Bytestring0/FPGA_RV32IM_VibeOS/README.md

> **2026-11-03 低资源架构重构：** [共享算术、TCM/DDR桥压缩、矩阵尺度融合及最终整机验收](docs/npu/AREA_REARCH_20261103.md)。保留硬件加速，已完成稳定CPU+NPU+Cache仿真；整机资源和时序正在真实PDS实现，板端模型吞吐与质量仍待验证。此前进度见[优化检查点](docs/npu/OPTIMIZATION_20261103.md)。

> **2026-11-02 NPU 集成交接：** 当前矩阵/tensor 加速器、Cache/DDR 集成修改、完整 Agent 构建和后续优化入口见 [NPU_HANDOFF.md](NPU_HANDOFF.md)。最新整机时序、板端吞吐和模型质量仍待验收。

# AG：六级流水线双发射 RISC-V CPU

面向紫光同创赛题一的自主 SystemVerilog CPU 与最小 SoC。支持 RV32IM + Zicsr/Zifencei + Zba/Zbb、六级顺序流水线、动态通道交换双发射、四项指令队列、局部历史预测和返回地址栈、精确异常与机器态中断。

2026-10-29 当前 AG 独立重建板测：**102 MHz、514.346581 CoreMark、5.042614 CoreMark/MHz、7023 LUT、0.073237446 CoreMark/LUT**，6000 轮用时 11.665286 秒，CRC、UART、JTAG 回读均通过；setup +0.156 ns。独立 ILA 版本同样闭合并通过完整基准，真实捕获 2048 点链表/CRC 循环，窗口退休 2286 条、IPC 1.1162，477 周期双退休。以上为 TCM SoC 指标，完整 DDR/Cache 配置独立统计。见[本次 AG 指标与 ILA 原始证据](docs/results/ag-contest-20261029/README.md)、[逐项赛题核验](docs/赛题一RV侧完成情况与指标.md)。108 MHz 已结束的对照未闭合，按用户要求不再实现。

项目现更名为 **AG**，生产 RTL、仿真、构建脚本和 DDR IP 使用 `ag_*`；历史归档保留原文件名、UART 和哈希。改名后两个完整 DDR/Cache 102 MHz 重建在限时内未完成布线，尚无新的完整 SoC 板测/CoreMark；[详细结果与日志](docs/results/ag-contest-20261029/README.md)已保留。

2026-10-29：**完整 CPU + 两路 I/D Cache（各 16 KiB）+ 板载 DDR3 的 102 MHz 冻结闭合版已通过实板自检与 JTAG 回读校验**。两次下载均通过 DDR 校准、数据/代码执行、MULH、MIN/MAX、Cache 命中、自修改及维护测试；第二次完成配置回读。该冻结位流 CPU setup +0.056 ns、slow/fast hold +0.136/+0.099 ns，整机 14618 LUT。短仿真 CoreMark 等效 5.041916/MHz，尚无完整 DDR/Cache 位流正式实板 CoreMark。见[本次实测证据](docs/results/board-ddr-cache-102mhz/README.md)、[原始闭合归档](docs/results/offline-ddr-cache-102mhz/README.md)、[RV 接口](docs/RV侧接口文档.md)。

历史 2026-10-26 TCM 位流为 7089 LUT、setup +0.120 ns、0.072556 CoreMark/LUT；2026-10-28 DDR 实验镜像 setup −1.022 ns，未闭合。历史数据分别见[性能与验证报告](docs/性能与验证报告.md)与[DDR 实验板测记录](docs/results/board-ddr-102mhz-experimental/README.md)，不可混用到当前 AG 的面积或成绩。

## 文档

- [板载 DDR3 接入与验证](docs/板载DDR3接入与验证.md)：IP 配置修正、时钟/引脚、CPU 接口、自检和独立 PDS 工程。
- [模型加速器整合与浏览器方案](docs/模型加速器整合与浏览器方案.md)：团队 W4A8 核心审查、模型候选，以及当前唯一确定的 AI 浏览器应用。

- [CPU 设计说明](docs/CPU设计说明.md)：架构、双发射、旁路、总线、CSR、地址空间及 OS/AI 接入边界。
- [AG OS 与即时应用设计](docs/AGOS与即时应用设计.md)：简化 VibeOS 的方案，含 AI 计算器、AI 网页、生成式应用商店、应用脚本、DDR 与持久化；目前为设计稿。
- [性能与验证报告](docs/性能与验证报告.md)：赛题三个性能指标、周期、资源、时序、限制与复现命令。
- [PDS 使用说明](docs/PDS使用说明.md)：解决“没有文件”、同步源码与运行流程。
- [NPU完整模型首次运行](docs/npu/NPU_MODEL_RUN_20261103.md)：完整W4模型通过生产NPU RTL协同仿真、54MHz物理实现与模型启动入口。
- [低资源NPU架构与实测](docs/npu/AREA_REARCH_20261103.md)：低资源重构、整机资源/时序、模型RTL和板端状态。
- [上板调试记录](docs/上板调试记录.md)：历史27/81/108 MHz测试、JTAG下载和证据位置。

## 在 PDS 中运行

打开 **D:\FPGA\RiscV\RiscV.pds**，顶层为 ag_fpga_top，器件 PG2L100H-6 / FBG676，综合器选择 ADS。

1. 关闭之前的空工程，避免将旧的空文件列表保存覆盖新工程。
2. 重新打开 RiscV.pds，源文件列表应包含 ag_all.sv。
3. 运行 Compile → Synthesize → Device Map → Place & Route → Report Timing。

修改原始 rtl/*.sv 后，在 PowerShell 中同步：

```powershell
Set-Location D:\FPGA\RiscV
.\scripts\sync_pds_project.ps1
```

该命令按 rtl/files.f 合并 RTL 文件到 fpga/generated/ag_all.sv，复制 smoke 固件到根目录 firmware.hex，并写入完整的 PDS 工程设置。只添加合并文件可规避旧版 PDS 的 package 兼容问题；不要同时添加原始模块。

独立命令行综合与布局布线：

```powershell
.\scripts\build_fpga.ps1
.\scripts\build_fpga.ps1 -PlaceRoute
```

根工程顶层使用原始 27 MHz 时钟与对应 UART 分频。根工程约束为 110 MHz 时序探索目标，不包含板级引脚分配，也不会自动生成 PLL；实板请使用 `scripts/prepare_board.ps1` 生成的完整板级工程。102 MHz 基准镜像位于 `build/board102-payload-refine/`，DDR 集成工程由 `scripts/prepare_ddr_board.ps1` 单独生成。源码、固件和时序按各自 manifest 核对，不能混用。外部 Flash 固化及断电启动尚未执行。

## 编译与仿真

依赖 WSL Ubuntu、make、g++、python3、Verilator、gcc-riscv64-unknown-elf 和 binutils-riscv64-unknown-elf。工具链虽叫 riscv64，编译明确选择 RV32/ILP32。

```bash
cd /mnt/d/FPGA/RiscV
make deps                        # 固定版本 CoreMark / riscv-tests
make check                       # ISA、异常、中断、双发射、差分、UART 波形
make coremark                    # RV32IM 普通 -O3 基线
make coremark-opt                # Zba/Zbb 与优化编译配置，短测 10 轮
make coremark-opt ITERATIONS=6000 CPU_HZ=110000000
make coremark-opt ITERATIONS=6000 CPU_HZ=110000000 VALIDATION=1
make smoke                       # 恢复仿真启动镜像
```

coremark-opt 使用完整上游算法，附加 -funroll-all-loops、-finline-limit=1000、-frename-registers、-mtune=sifive-7-series。最后一个选项仅调整 GCC 调度模型，不引入第三方 CPU IP。日志保存实际编译参数和三个算法 CRC。

CPU_HZ 仅用于计时换算；上板时必须等于实际主频。6000 次迭代用于按 110 MHz 换算时超过 10 秒的逻辑时间验证，仍然属于仿真结果。短测会显示上游持续时间不足提示，测试脚本只允许该提示，不忽略其他错误。

| Make 参数 | 默认 | 含义 |
| --- | ---: | --- |
| DUAL_ISSUE | 1 | 顺序双发射，0 为单发射 |
| LOAD_BYPASS | 1 | 成功的 MEM Load 响应旁路 EX |
| EARLY_LSU | 1 | EX 发起访存，MEM 接收同步响应 |
| PREDICT | 1 | 分支预测 |
| BTB_BITS | 8 | 256 项 BTB；可比较 6/8/9 |
| ITERATIONS | 10 | CoreMark 迭代次数 |
| VALIDATION | 0 | 0 为 performance，1 为 validation 种子 |
| CPU_HZ | 27000000 | 固件计时换算参数 |

Make 参数控制仿真；PDS 使用 RTL 默认参数。各 SoC 测试共享 build/firmware.hex，请顺序运行，不要在多个终端同时启动 make coremark/smoke/isa 等目标。

## 工程结构与交付边界

| 目录 | 内容 |
| --- | --- |
| rtl/ | CPU、ALU、译码、预测器、CSR、除法、SoC、FPGA 顶层 |
| sim/ | SoC 模型、独立退休参考模型、UART 波形检查 |
| tests/ | 异常、中断、双发射和 MMIO 专项 |
| sw/ | 启动、链接脚本、示例、CoreMark 移植层 |
| scripts/ | 固件生成、差分、PDS 构建和同步 |
| fpga/ | 工程模板、合并源码、约束 |
| docs/results/ | 选定版本的验证日志、资源及时序证据 |
| build/ | 可重新生成的中间文件与实验日志 |
| third_party/ | 固定版本基准/测试代码及许可证 |

最小 SoC 集成 64 KiB TCM、UART TX、GPIO、定时器和软件中断。另有可选 DDR 集成：PDS HMIC_S IP、跨时钟桥，以及独立的两路 I/D Cache（板级各 16 KiB、32 字节行、D 写回/写分配、FENCE.I 维护）。Cache 已通过功能/性能仿真，并有 102 MHz 实验镜像通过 DDR、自修改代码、维护及 JTAG 板测；该镜像 14,603 LUT、setup −0.306 ns，尚未闭合。当前源码仍在优化，完整状态及冻结证据见 [Cache 设计与性能](docs/两路Cache设计与性能.md)。操作系统、AI 加速器系统整合、键盘/HDMI、UART RX 与持久化存储尚未实现。

## RV 侧交付文档

- [RV 侧接口文档](docs/RV侧接口文档.md)：端口协议、MMIO、DDR/Cache、异常中断和后续 AI 接入边界。
- [赛题一 RV 侧完成情况与指标](docs/赛题一RV侧完成情况与指标.md)：逐条对照、分版本指标、原始证据和待验收事项。
