Bytestring0/FPGA_RV32IM_VibeOS/提交材料/05_时序与资源/README.md

# 时序与资源（PDS 2025.2）

## 已闭合工程：`npu_hot102_20261104`
- 时序报告结论：**Design Summary : All Constraints Met**
- CPU 时钟：102 MHz（正裕量 +0.176 ns）
- DDR PHY 时钟：正裕量 +0.251 ns
- 综合资源：LUT **46,747 / 66,600（70.19%）**；DRM 99.5 / 155（64.19%）；APM 116 / 240（48.33%）
- 位流：`08_位流与镜像/ag_npu_board_top_sbit_hot102.bin`（已在实板运行）

原始报告：`timing_hot102.rtr`

## 进行中：真突发版（`npu_burst16_102_20261104`）
- 综合：LUT 46,782（70.24%），DRM 100.0，APM 115.0 —— 与闭合版基本一致
- 首次布线：**未闭合**，WNS −0.441 ns，失败路径为 TCM 写使能跨 RAM bank 走线（非突发逻辑）
- 正在用第二个布局种子重跑

## 说明
- 表中数字均取自 PDS 报告，未做估算。
- 突发版在时序闭合前**不进入提交与实板**。
