Bytestring0/FPGA_RV32IM_VibeOS/提交材料/07_AI应用/待补_HDMI截图.md

# HDMI 界面截图（待补）

需要归档：
1. 主菜单（5 个条目）
2. 虚拟键盘输入态
3. 工具调用与回执
4. CoreMark 结果页
5. 模型装载进度条

拍摄/截取后放入本目录，并在 `07_AI应用/README.md` 中引用。
