Bytestring0/FPGA_RV32IM_VibeOS/提交材料/07_AI应用/待补_识别率.md

# 识别率 / 任务成功率（未测）

**当前没有任何可提交的量化数据。**

需要补的测量方案（建议）：
1. 固定 20–50 条任务提示（计算类、查询类、计时类、自由问答类各若干）
2. 每条记录：是否调用正确工具、参数是否正确、最终答复是否正确
3. 统计：工具调用成功率、任务完成率、错误类型分布

注意：模型 `quality_approved=0`，在完成上述测量前不得声称达到 BF16 等价质量。
