Bytestring0/FPGA_RV32IM_VibeOS/提交材料/09_演示视频/待补_演示视频.md

# 演示视频（待录制）

建议录制内容：
1. 上板启动 → HDMI 主菜单
2. 按键选择 AI 任务 → 装载进度条 → 模型推理与工具调用回执
3. 虚拟键盘/串口键盘输入一句自由对话
4. CoreMark 页面现场跑分（≥10 秒）与结果
5. （若完成）ILA 抓取波形演示
