Bytestring0/FPGA_RV32IM_VibeOS/docs/results/cache-area/manual/hardware-p20.png

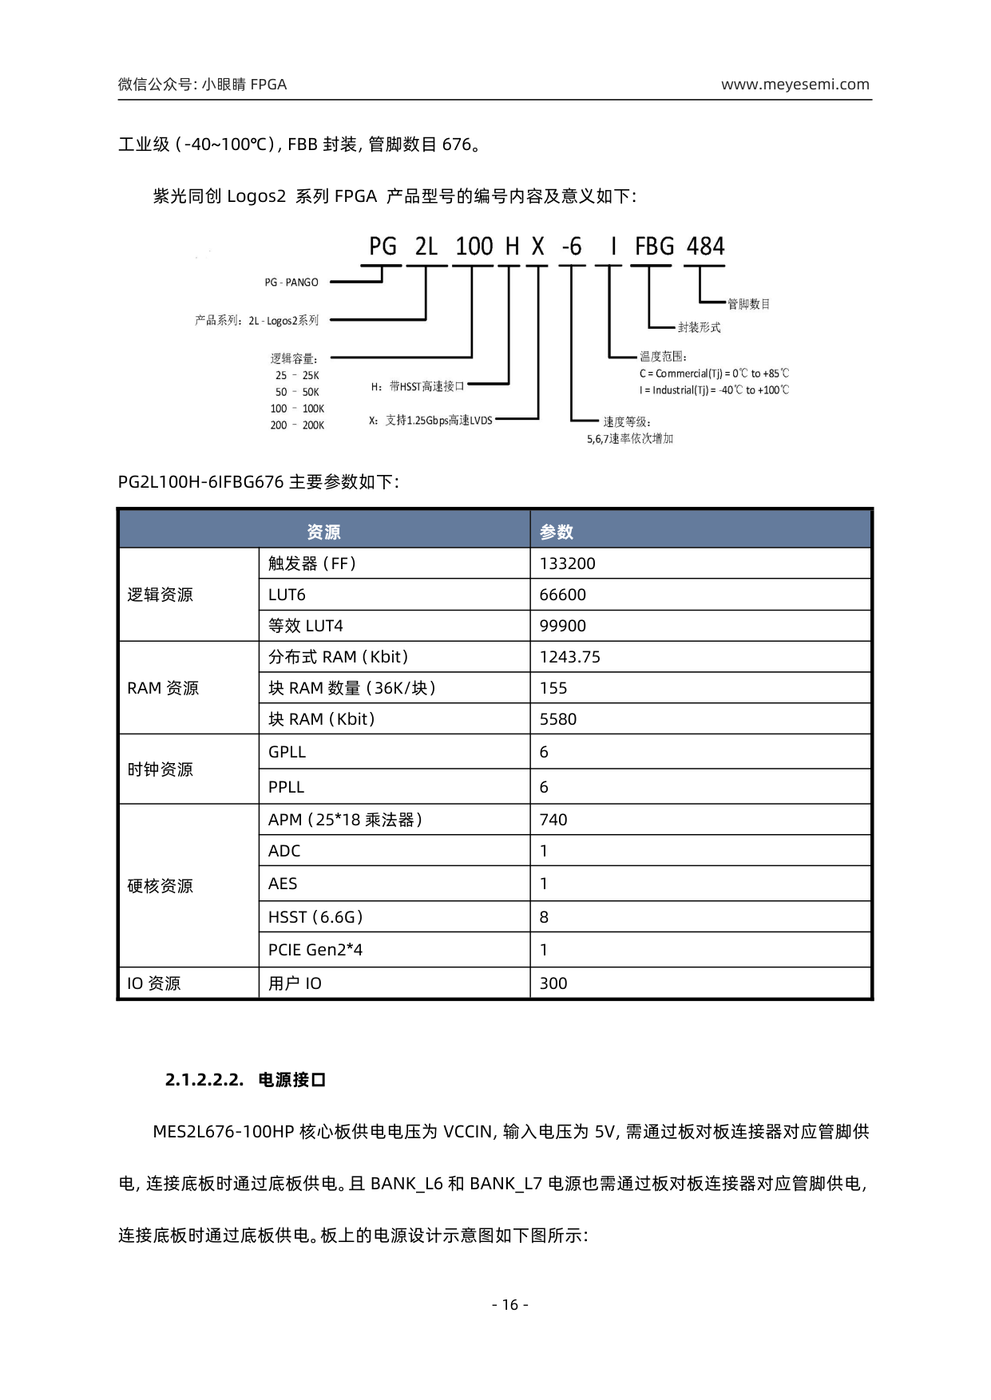
docs/results/cache-area/manual/hardware-p20.png
