Bytestring0/FPGA_RV32IM_VibeOS/docs/results/cache-timing-candidates/README.md

# 时序候选记录

2026-10-29，板卡未连接。Word-only Load 旁路候选（MULH_PIPELINE=1、LOAD_WORD_ONLY=1）通过 219 轮差分，102240 条提交指令；仅改变板级参数，不改变通用核默认值。该记录不构成时序或板测通过证明。物理实现结果另见赛题完成情况文档。
