Bytestring0/FPGA_RV32IM_VibeOS/docs/results/cache-timing-candidates/seed1-first/README.md

# 完整旁路、布局种子 1：第一轮最终路由

2026-10-29。当前源码，CPU 102 MHz、DDR UI 125 MHz、I/D 各 16 KiB。CPU setup −0.095 ns、9 个端点；DDR PHY 域到输出域有一条 −0.461 ns，故整机不通过时序。没有生成或下载正常位流。hold 优化参数为 100 ps；报告与资源来自第一轮完成的独立实现目录，后续迭代不继承为本轮通过结果。
