Bytestring0/FPGA_RV32IM_VibeOS/docs/results/cache-timing-candidates/seed1-priority-incomplete/README.md

# 种子 1 优先布线尝试：未完成，不可生成正常位流

源代码与 seed1-first 相同。布线过程到达 0 未连接网络，但进程结束后没有留下最终 PNR 数据库和 report_timing 报告；此处仅保留中间 hold 修复后的摘要。

中间 CPU setup −0.566 ns（13 个端点），DDR PHY 快角 hold −0.009 ns。不能称为收敛，也不能用该摘要替代正式最终报告。下一步已改 RTL，将旋转和位计数运算从 EX 旁路路径移到已有 MEM 级。
