Bytestring0/FPGA_RV32IM_VibeOS/docs/results/cache-timing-candidates/word1-first/README.md

# 字加载旁路候选，不采用

2026-10-29。第一轮最终 CPU setup −0.630 ns，89 个端点，DDR UI +1.146 ns，各时钟 hold 通过。不能闭合 102 MHz，也未证明相对完整旁路的收益，停止后续迭代，保留 LOAD_WORD_ONLY=0 默认性能配置。没有生成或下载正常位流。差分通过不代表静态时序通过。
