Bytestring0/FPGA_RV32IM_VibeOS/docs/results/ag-contest-20261029/ila-analysis/samples.csv

sample | time_ns | x_pc | m_pc | retire_valid | retire_second_valid | x_dec_branch | x_function
0 | 0.0 | 00000588 | 00000494 | 0 | 0 | 1 | core_bench_list
1 | 9.803921568627452 | 00000498 | 00000494 | 0 | 0 | 0 | core_bench_list
2 | 19.607843137254903 | 000004a0 | 00000498 | 0 | 0 | 0 | core_bench_list
3 | 29.41176470588235 | 000004a4 | 000004a0 | 1 | 1 | 1 | core_bench_list
4 | 39.21568627450981 | 000004a8 | 000004a4 | 1 | 0 | 0 | core_bench_list
5 | 49.01960784313726 | 000004b0 | 000004a8 | 1 | 0 | 1 | core_bench_list
6 | 58.8235294117647 | 00000494 | 000004b0 | 1 | 1 | 1 | core_bench_list
7 | 68.62745098039215 | 00000494 | 000004b0 | 1 | 0 | 1 | core_bench_list
8 | 78.43137254901961 | 00000494 | 000004b0 | 0 | 0 | 1 | core_bench_list
9 | 88.23529411764706 | 00000494 | 000004b0 | 0 | 0 | 1 | core_bench_list
10 | 98.03921568627452 | 000004b4 | 000004b0 | 0 | 0 | 1 | core_bench_list
11 | 107.84313725490196 | 000004b8 | 000004b4 | 0 | 0 | 1 | core_bench_list
12 | 117.6470588235294 | 000004b8 | 000004b4 | 1 | 0 | 1 | core_bench_list
13 | 127.45098039215686 | 000004b8 | 000004b4 | 0 | 0 | 1 | core_bench_list
14 | 137.2549019607843 | 000004b8 | 000004b4 | 0 | 0 | 1 | core_bench_list
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
