Bytestring0/FPGA_RV32IM_VibeOS/docs/上板调试记录.md

# AG CPU 上板调试记录

首次测试时间：2026-10-22；最新 AG CPU 基准与 ILA 板测：2026-10-29。使用 PDS 2022.2-SP6.1、FTDI JTAG 下载器和板载 CP210x 串口。

## 当前 AG 重建基准与 ILA：2026-10-29

当前源码独立生成的 TCM 工程在 102 MHz 闭合，setup +0.156 ns；7023 LUT / 2563 FF。6000 轮 CoreMark 1,189,859,177 周期，11.665286 秒，514.346581 CoreMark，5.042613543/MHz，0.073237446/LUT；CRC、COM12 输出与执行结束后的 JTAG 回读均通过。独立 ILA 工程 setup +0.313 ns / 7655 LUT，完整基准周期不变且回读通过。实板立即采样取得 2048 点链表/CRC 循环，窗口 IPC 1.116210938，477 周期双退休；原始 WDF、截图、CSV 与限制详见[当前 AG 证据](results/ag-contest-20261029/README.md)。108 MHz 已完成对照未闭合，用户要求不再继续该频点。下文保留历史记录。

## 最新闭合 DDR/Cache 板测：2026-10-29

完整 CPU 102 MHz、DDR UI 125 MHz、DDR3 1000 MT/s、I/D Cache 各 16 KiB 的冻结闭合版已在 COM12 上两次下载并通过功能自检。第二次在自检结束后完成 JTAG 配置回读，ID `0x00602899`。首次遗漏 `.smsk` 导致回读失败，补齐同版掩码并核对位流哈希后重测通过；原始日志全部保留。见[本次实测归档](results/board-ddr-cache-102mhz/README.md)。未写 Flash，未测该完整 SoC 的正式 CoreMark。以下旧名、旧路径和 UART 原文为历史记录；当前 AG 脚本生成 `ag_*` 工程，旧 profile 应使用冻结版本脚本。

## 历史 DDR 功能板测：2026-10-28

CPU 102 MHz、DDR3 1000 MT/s 实验配置已通过校准、16 KiB 数据、字节/半字写、地址线/末字抽查及 DDR 代码执行，完整 UART PASS 与 JTAG 校验通过。当前最后下载至配置 RAM 的镜像为 `build/ddr-soc102-grant-refine/generate_bitstream/qinglong_board_top.sbit`，未写 Flash。该 DDR 整机 CPU setup −1.022 ns，尚未闭合。证据见[DDR 实验板测归档](results/board-ddr-102mhz-experimental/README.md)。

## 最新 CPU 基准：102 MHz 时序闭合并上板

| 配置 | 实板 CoreMark | CoreMark/MHz | 实现后 LUT | CoreMark/LUT | 状态 |
| --- | ---: | ---: | ---: | ---: | --- |
| 81 MHz，6000 次迭代 | 408.451697 | 5.042614 | 6803 | 0.060040 | 两次一致；setup/hold 全部通过 |
| 102 MHz，6000 次迭代 | 514.346581 | 5.042614 | 7089 | 0.072556 | UART、JTAG 校验通过；setup/hold 全部通过 |
| 108 MHz，8000 次迭代 | 544.602348 | 5.042614 | 7124 | 0.076446 | 两次一致；setup WNS −0.346 ns，尚未闭合 |

102 MHz 为当前同时满足最终时序和实板基准的最高频率。6000 次迭代使用 `1,189,859,177` 周期，耗时 11.665286 秒；CRC `e714 / 1fd7 / 8e3a`。setup WNS +0.120 ns，slow/fast hold 最小裕量 +0.059 / +0.041 ns。精确 CoreMark 按周期计算，UART 整数秒打印出的 `Iterations/Sec=545` 不是精确分数。见[102 MHz 板测归档](results/board-102mhz/README.md)。这些面积与成绩属于 TCM 基准工程，不是加入 DDR 后的完整 SoC。

108 MHz 两次均为 `1,586,478,654` 周期（`000000005e8fbe3e`），算法 CRC `e714 / 1fd7 / 8e3a`，JTAG 校验通过。频率来自 27 MHz 标称晶振经 GPLL ×4，未外接频率计校准；两次通过不代表覆盖全部工作条件。

上述均下载至易失配置 RAM，未写入外部 Flash。10 月 27 日重新连接时 JTAG 识别 PG2L100H、ID `0x00602899`，DONE=0，说明此时未处于已配置状态；不能假定上次镜像在断电后仍保留。DDR 集成工程进度独立记录在[板载 DDR3 接入与验证](板载DDR3接入与验证.md)。完整分析及 CPU 下载命令见[性能与验证报告](性能与验证报告.md)。

以下保留此前 27 MHz 首次启动记录，其中“当前镜像”等表述仅代表当时状态。

## 已完成的 27 MHz 启动验证

- JTAG 识别器件 PG2L100H，ID `0x00602899`。
- 板级工程使用 `build/board27/qinglong_board.pds`，顶层 `qinglong_board_top`。
- 时钟直接使用 D18 的板载 27 MHz 输入；复位 C22，UART TX C24，接口为 LVCMOS33。
- 底板 UART USB-C 独立连接电脑，枚举为 **COM12**；115200 baud、8N1、无流控。
- 对当前源码和 smoke 固件重新编译、综合、布局布线，并从本次数据库生成 `.sbit`。
- 时序报告为 `All Constraints Met`，慢角 setup WNS +20.446 ns，最小快角 hold slack +0.087 ns。
- 连续三次 JTAG 下载，均 DONE=1、配置校验通过，并收到以下完整 UART 输出：

```text
QingLong RV32IM boot OK, hash=f60ac131
```

测试记录：`build/board-smoke-run1.uart.log`、`run2`、`run3`；各自 `.program.log` 保存下载、配置校验及状态寄存器结果。`build/board27/manifest.json` 记录源码、固件、约束和位流哈希。配置校验按 PDS 定义不比较 DRM 内容；UART 执行结果另外验证了本次启动固件。

配套 RTL 仿真 `make smoke uart-soc` 通过，日志为 `build/board-debug-sim.log`。smoke 的仿真退出码为 0，hash 与实板一致。UART SoC 测试通过连续六次 MMIO 写入、8N1 波形及交错 RAM 访问检查。

## CoreMark 实板结果

采用 GCC 13.2.0、RV32IM/Zicsr/Zifencei/Zba/Zbb、`-O3 -funroll-all-loops -finline-limit=1000 -frename-registers -mtune=sifive-7-series`，performance 种子，2000 次迭代。板级配置为双发射、256 项 BTB、Load 旁路与 early LSU。

| 项目 | 结果 |
| --- | --- |
| 实板计时周期 | 396,619,914，十六进制 `0000000017a3f08a` |
| 两次成功运行 | 周期及 CRC 完全一致 |
| 同固件 RTL 仿真 | 同为 396,619,914 周期，退出码 0 |
| list / matrix / state CRC | `e714 / 1fd7 / 8e3a`，全部通过 |
| 上游校验 | `Correct operation validated` |
| 按 27 MHz 换算耗时 | 14.689626 秒 |
| CoreMark | 136.150501 |
| CoreMark/MHz | 5.042611 |
| 同镜像 Device Map LUT / FF / DRM / APM | 6634 / 2425 / 48 / 4 |
| 整体 CoreMark/LUT | 0.020523 |

时间和每秒成绩以板载 27 MHz **标称**晶振、PLL 旁路为依据，未另用频率计校准。UART 中整数 `Total time (secs)=14`、`Iterations/Sec=142` 有截断，不能替代完整周期换算。此处为实板测试记录，未经 EEMBC 认证。资源边界为整个 SoC，包含 TCM、UART 和 GPIO。

原始 UART、下载校验日志、仿真对照、时序、资源和 manifest 已归档至 `docs/results/board-27mhz/`。CoreMark 位流及工程保存在 `build/board27-coremark/`，当前 FPGA 中最后下载的是这个镜像。

本次采用易失的 FPGA 配置 RAM 下载。尚未执行外部 Flash 固化、断电重启测试、validation 种子长测或高频 PLL 稳定性测试。

## 本次修复

1. Config 无法启动：PDS `bin/ftd2xx.dll` 是依赖缺失 CH347 库的替代版本，返回 `0xC0000135`。备份后恢复 PDS 自带的 amd64 FTDI 3.02.09 库，Config 和 JTAG 扫描恢复。
2. 旧位流早于最新板级源码与布局布线结果，重新生成当前版本。
3. `prepare_board.ps1` 的裸 `save_project` 在命令行流程中报 `Flow-4055`，阻断生成位流，现已移除。
4. PDS 会预解析 Tcl 的文件读取，不能在全新目录的同一 Tcl 中先构建、再读取尚未生成的时序报告。现在由 PowerShell 检查新时序报告，再在独立 PDS 调用中显式选择器件并读取本次布局布线数据库生成位流。
5. 新增 `program_board.ps1` 和 `program_board.tcl`，串口在下载前打开，自动核对构建哈希、执行 JTAG 编程、捕获预期 UART 文本，再执行配置校验。
6. 实测发现：下载后立即 `cfg_verify` 时 smoke 可完成，但 CoreMark 在 90 秒内无 UART 输出；同一镜像仅下载时能完成。调整为 **下载 → 等待完整 UART 结果 → 配置校验** 后，CoreMark 再次以相同周期和 CRC 完成，后续校验也通过。长程序运行时避免执行配置回读/校验。

## 复现

从 `D:\FPGA\RiscV` 的 PowerShell 执行：

```powershell
# 基础启动镜像
.\scripts\prepare_board.ps1 -ClockMHz 27 -Firmware build\smoke.hex -Build -Bitstream
.\scripts\program_board.ps1 -Port COM12 -Output build\board-uart.log
```

CoreMark 固件与完整镜像的复现：

```powershell
wsl -d Ubuntu-24.04 -- bash -lc 'cd /mnt/d/FPGA/RiscV && make coremark-build ITERATIONS=2000 CPU_HZ=27000000 MARCH=rv32im_zicsr_zifencei_zba_zbb EXTRA_CFLAGS="-funroll-all-loops -finline-limit=1000 -frename-registers -mtune=sifive-7-series" && cp build/coremark.hex build/board-coremark-performance.hex'
.\scripts\prepare_board.ps1 -ClockMHz 27 -Firmware build\board-coremark-performance.hex -OutputDirectory build\board27-coremark -Build -Bitstream
.\scripts\program_board.ps1 -Port COM12 -Profile build\board27-coremark -Output build\board-coremark.uart.log -Expected 'MEASURED_CYCLES_HEX=[0-9a-fA-F]{16}\r?\n'
python scripts\analyze_board_coremark.py build\board-coremark.uart.log --clock-hz 27000000 --luts 6634
```

`program_board.ps1` 的预期文本只判断采集完成；CoreMark 算法和持续时间校验由 `analyze_board_coremark.py` 执行。

串口号由 Windows 分配；换 USB 插口后以设备管理器中的 CP210x 端口为准。FTDI COM10/COM11 属于下载器，不是底板 UART。

根目录 `RiscV.pds` 使用不含引脚分配的 `fpga/timing.fdc`，用于时序探索。新生成的实板工程应打开 `build/board27/ag_board.pds` 或使用脚本生成的其他完整板级 profile。
