Bytestring0/FPGA_RV32IM_VibeOS/fpga/board/audit_ddr_queue4_cdc.py

"""Audit real PDS mapped cell hierarchy and SDC binding annotations.
PDS get_cells returns symbolic handles, not Tcl lists. Read the mapped VM and
its exact board.fdc; bind every reported group to actual cells/constraint IDs.
"""
import argparse
import fnmatch
import json
import re
from pathlib import Path


MODULE = re.compile(r'^[ \t]*module\s+(\w+)\b(.*?)^endmodule\b', re.M | re.S)
INSTANCE = re.compile(r'^\s*(GTP_\w+|ag_hmic_\w+)\s+(?:/\*.*?\*/\s*)?(?:#\s*\(.*?\)\s*)?(\\\S+|[A-Za-z_]\w*)\s*\((.*?)\);', re.M | re.S)
ANNOT = re.compile(r'SDC constraint\s*:\s*\(object ([^)]+)\)\s*\(id (\d+)\)\s*\((?:cell\s+)?(from|to)\)\s*\((\d+)\s*:\s*([^\n]+)\)')


def normalized_path(value):
    value = str(value).replace('\\', '/').strip().lower()
    return re.sub(r'^/mnt/([a-z])/', lambda m: m.group(1) + ':/', value)


def mapped_cells(text):
    # ADS 2025 emits attributes immediately before module and instance names.
    text = re.sub(r'[(][*].*?[*][)]', '', text, flags=re.S)
    modules = {}
    for module in MODULE.finditer(text):
        name, body = module.group(1), module.group(2)
        if name != 'ag_npu_board_top' and not name.startswith('ag_hmic_'):
            continue
        body = body[body.find(');') + 2:]
        matches = list(INSTANCE.finditer(body))
        rows = []
        for i, match in enumerate(matches):
            tail = body[match.end():matches[i + 1].start() if i + 1 < len(matches) else len(body)]
            rows.append({'type': match.group(1), 'name': match.group(2).lstrip('\\'), 'pins': match.group(3),
                         'annotations': [{'pin': a[0], 'id': int(a[1]), 'direction': a[2], 'line': int(a[3]), 'file': a[4]} for a in ANNOT.findall(tail)]})
        modules[name] = rows
    if 'ag_npu_board_top' not in modules:
        raise ValueError('mapped top ag_npu_board_top missing')
    cells = []
    def visit(module, prefix, parent_nets=None):
        parent_nets = parent_nets or {}
        def resolve(net):return parent_nets.get(net.strip(), (prefix+'/' if prefix else '')+net.strip())
        def connections(pins):return {m.group(1):resolve(m.group(2)) for m in re.finditer(r'\.(\w+)\s*\(([^()]+)\)',pins)}
        for row in modules[module]:
            path = prefix + '/' + row['name'] if prefix else row['name']
            if row['type'] in modules:
                visit(row['type'], path, connections(row['pins']))
            elif row['type'].startswith('GTP_'):
                cells.append(dict(row, path=path, resolved_pins=connections(row['pins'])))
    visit('ag_npu_board_top', '')
    if not any(c['path'].startswith('bridge/') for c in cells):
        raise ValueError('real mapped bridge hierarchy missing')
    return cells


def cell_query(expression, cells):
    match = re.fullmatch(r'\[get_cells\s+([^{}]*)\{([^}]+)\}\]', expression.strip())
    if not match:
        raise ValueError('unsupported cell query ' + expression)
    options, pattern = match.groups()
    if '-regexp' in options:
        return [c for c in cells if re.fullmatch(pattern, c['path'])]
    if re.search(r'(?:wgray|rgray)(?:_r1|_w1)?$', pattern):
        # FDC is evaluated on RTL bus registers; mapped VM scalarizes them.
        # Strip ONLY the three valid bit suffixes, never sync-stage suffixes.
        return [c for c in cells if fnmatch.fnmatchcase(re.sub(r'\[[0-9]+\]$', '', c['path']), pattern)]
    return [c for c in cells if fnmatch.fnmatchcase(c['path'], pattern)]


def bindings(rows, direction, line, fdc):
    result = None
    for cell in rows:
        ids = {a['id'] for a in cell['annotations'] if a['direction'] == direction and a['line'] == line and normalized_path(a['file']) == normalized_path(fdc.resolve())}
        if not ids:
            raise ValueError(f"unbound {direction} line{line} real cell {cell['path']}")
        result = ids if result is None else result & ids
    if not result:
        raise ValueError('no common applied constraint id')
    return result


def main():
    parser = argparse.ArgumentParser(description=__doc__)
    parser.add_argument('--netlist', required=True, type=Path)
    parser.add_argument('--fdc', required=True, type=Path)
    parser.add_argument('--output', type=Path)
    parser.add_argument('--depth', type=int, choices=(4,8,16,32), default=4)
    parser.add_argument('--require-precise', action='store_true')
    parser.add_argument('--require-bounded-gray', action='store_true')
    args = parser.parse_args()
    pointer_bits = args.depth.bit_length()
    expected_bits = {str(bit) for bit in range(pointer_bits)}
    text = args.netlist.read_text(errors='replace')
    fdc = args.fdc.read_text(errors='replace')
    # Derive CPU source period from the frozen generated-clock constraint,
    # then bind it to PDS's requested clock frequency after synthesis.
    board_clock = re.search(r'^create_clock -name board_27m -period ([0-9.]+)', fdc, re.M)
    generated = re.search(r'^create_generated_clock -name cpu_clk .*?-multiply_by ([0-9]+) -divide_by ([0-9]+)', fdc, re.M)
    direct = re.search(r'^create_clock -name cpu_clk -period ([0-9.]+)', fdc, re.M)
    if board_clock and generated:
        cpu_period_ns = float(board_clock.group(1)) * int(generated.group(2)) / int(generated.group(1))
    elif direct:
        cpu_period_ns = float(direct.group(1))
    else:
        raise ValueError('CPU source clock period not constrained')
    timing = args.netlist.with_name(args.netlist.name.replace('_syn.vm', '.snr'))
    if not timing.is_file():raise ValueError('PDS synthesis clock report missing')
    timing_text = timing.read_text(errors='replace')
    cpu_report = re.search(r'^\s*cpu_clk\s+([0-9.]+)\s+MHz', timing_text, re.M)
    ui_report = re.search(r'^\s*ddrphy_sysclk\s+([0-9.]+)\s+MHz', timing_text, re.M)
    if not cpu_report or not ui_report:raise ValueError('CPU or UI clock absent from actual PDS frequency table')
    cpu_mhz,ui_mhz = float(cpu_report.group(1)),float(ui_report.group(1))
    if cpu_mhz<=0 or ui_mhz<=0 or abs(1000/cpu_period_ns-cpu_mhz)>0.1:
        raise ValueError('PDS clock frequency differs from frozen FDC CPU period')
    ui_period_ns=1000/ui_mhz
    cells = mapped_cells(text)
    clock_nets={'cpu_clk':'cpu_clk'}
    top_body=next(m.group(2) for m in MODULE.finditer(re.sub(r'[(][*].*?[*][)]','',text,flags=re.S)) if m.group(1)=='ag_npu_board_top')
    ddr_instance=re.search(r'ag_ddr3\s+I_ips_ddr_top\s*\((.*?)\);',top_body,re.S)
    if not ddr_instance:raise ValueError('top-level DDR controller instance missing')
    ui_net=re.search(r'\.core_clk\s*\(([^)]+)\)',ddr_instance.group(1))
    if not ui_net or not re.search(r'create_generated_clock -name \{?ddrphy_sysclk\}? .*I_ips_ddr_top',fdc):raise ValueError('DDR UI generated clock binding missing')
    clock_nets['ddrphy_sysclk']=ui_net.group(1).strip()
    report = {'passed': False, 'netlist': str(args.netlist.resolve()),
              'fdc': str(args.fdc.resolve()), 'depth': args.depth,
              'scope': 'actual PDS mapped-cell and emitted SDC binding audit, not timing closure',
              'cpu_period_ns': cpu_period_ns, 'cpu_mhz': cpu_mhz,
              'ui_period_ns': ui_period_ns, 'groups': []}
    try:
        gray = payload = 0
        for lineno, line in enumerate(fdc.splitlines(), 1):
            if not line.startswith('set_max_delay '):
                continue
            clock_bound=re.fullmatch(r'set_max_delay\s+([0-9.]+)\s+-datapath_only\s+-from\s+\[get_clocks (cpu_clk|ddrphy_sysclk)\]\s+-to\s+\[get_clocks (cpu_clk|ddrphy_sysclk)\]',line)
            if clock_bound:
                limit,source_clock,target_clock=clock_bound.groups()
                if source_clock==target_clock or float(limit)>8:raise ValueError('invalid payload clock bound')
                fifo='requests' if source_clock=='cpu_clk' else 'responses'
                storage=[c for c in cells if '/'+fifo+'/payload' in c['path'] and c['type'].startswith('GTP_RAM')]
                if not storage:raise ValueError('payload storage missing for '+source_clock)
                if any(c['resolved_pins'].get('WCLK')!=clock_nets[source_clock] for c in storage):raise ValueError('payload write clock differs from selected source clock')
                register_clocks={c['resolved_pins'].get('CLK') for c in cells if '/'+fifo+'/' in c['path'] and c['type'].startswith('GTP_DFF')}
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
