Bytestring0/FPGA_RV32IM_VibeOS/(commit log)

2026-10-29 Implement RV32 cache and board DDR integration with verified contest evidence
2026-10-29 Close 102 MHz DDR cache SoC timing with MEM-stage bit operations
2026-10-29 rename qinglong -> ag, too bad name
    [samples.csv]
2026-11-02 Integrate current NPU accelerator and CPU/DDR/cache handoff
    Base on the latest CPU main f7f87ead59bc527861084e847b5975e9929bb152.
    Include the current tensor/matrix RTL, DMA/cache integration, model/Agent
    runtime, selected active acceptance tools, and concise continuation docs.
    Exclude model weights, obsolete deliveries, and generated build trees.
    Verify the explicit staged payload, seven concentrated acceptance stages,
    and the same stages from a clean indexed checkout. Firmware and APPRES
    are byte-identical between builds. Keep physical timing, board throughput,
    and full-model quality explicitly unapproved.
2026-11-04 Add submission package, 2025.2 ILA evidence, board firmware and AI fixes
    [ag_agent_ui.c, ag_agent_ui.h, ag_asset_loader.c, ag_asset_loader.h, ag_board_clock.sv, ag_board_system.sv]
